aqeelarshad19/apartment_door_connected/Images/20200323_183214.jpg

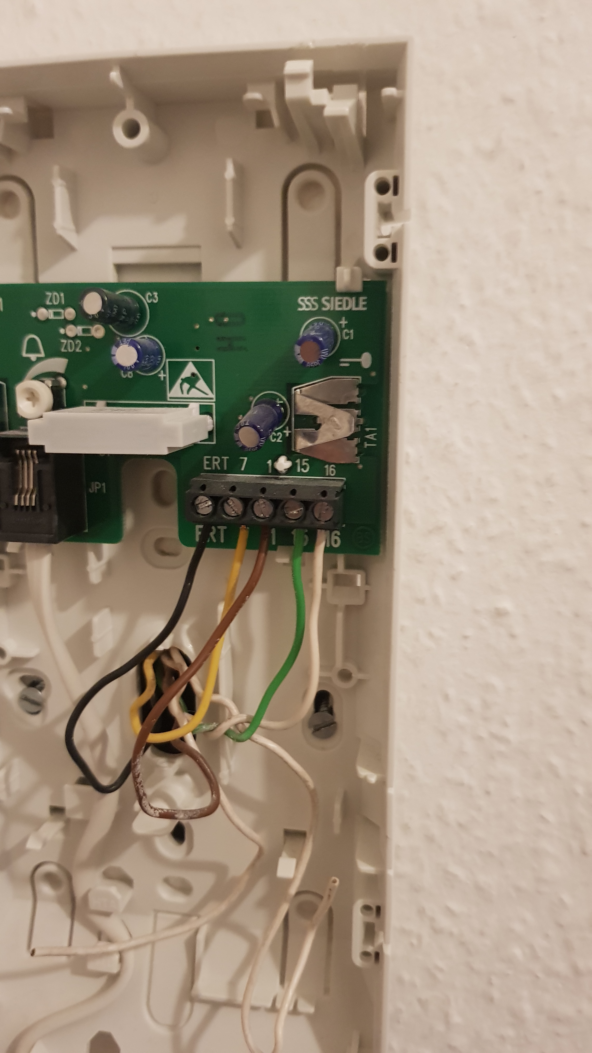
Images/20200323_183214.jpg
