aqeelarshad19/apartment_door_connected/Images/20200323_184217.jpg

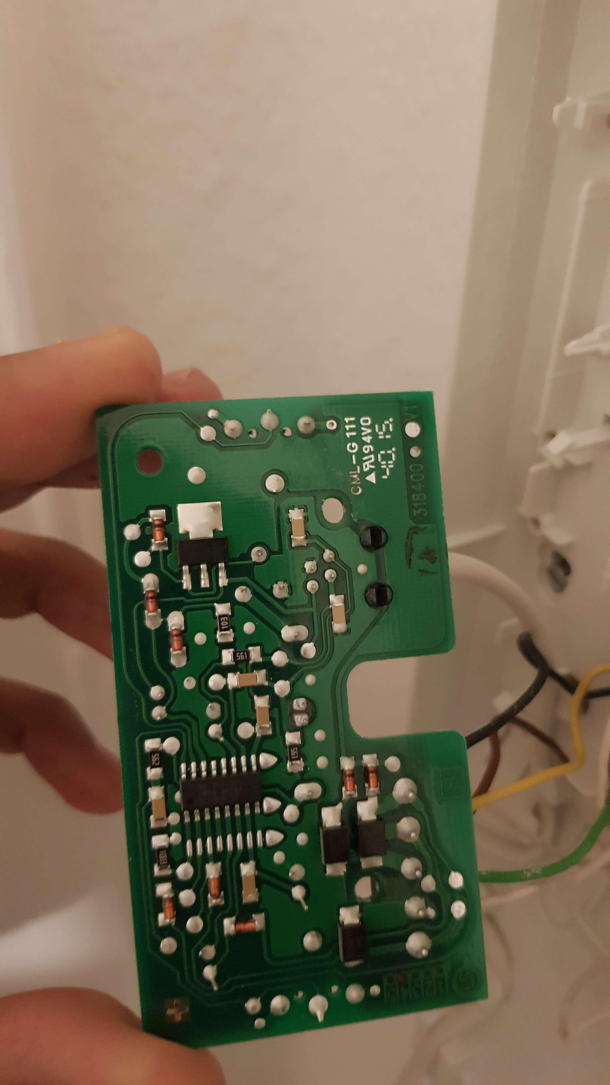
Images/20200323_184217.jpg
