aqeelarshad19/apartment_door_connected/Images/20200323_184233.jpg

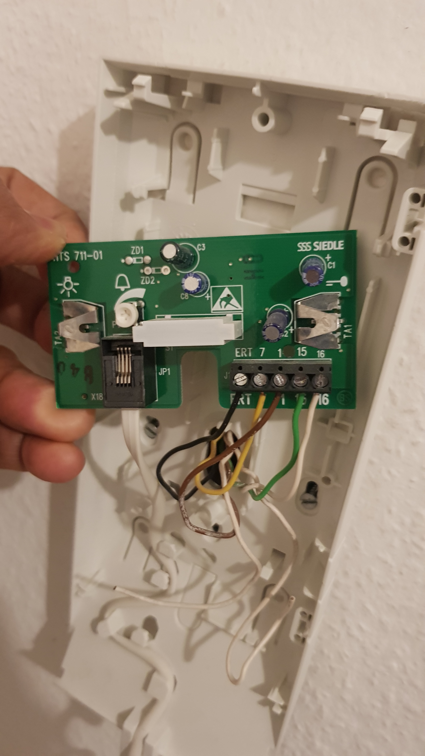
Images/20200323_184233.jpg
