aqeelarshad19/apartment_door_connected/Images/20200325_193451.jpg

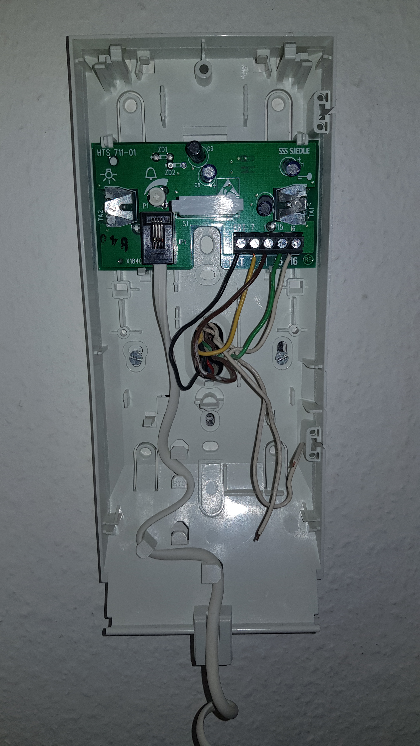
Images/20200325_193451.jpg
