aqeelarshad19/apartment_door_connected/Images/20200328_234504.jpg

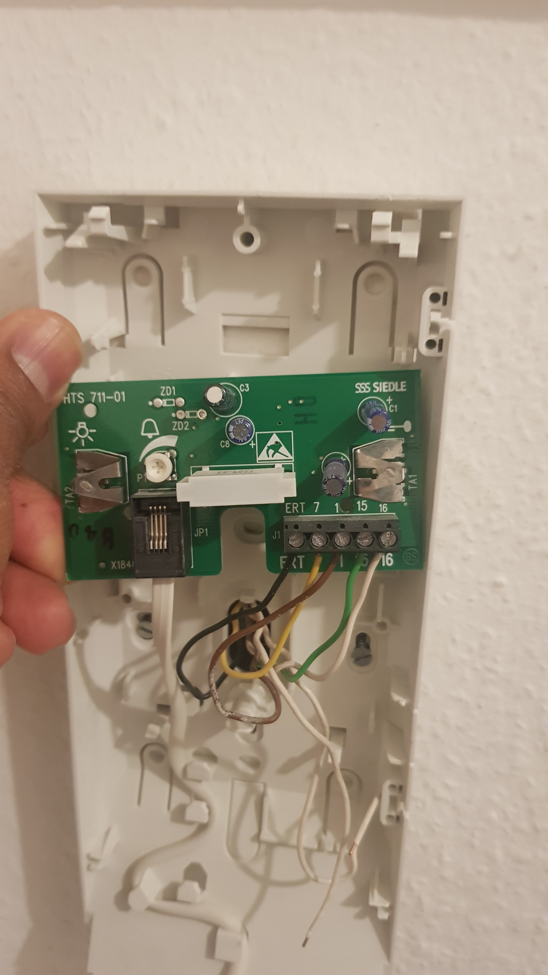
Images/20200328_234504.jpg
