aqeelarshad19/apartment_door_connected/Images/20200329_000736.jpg

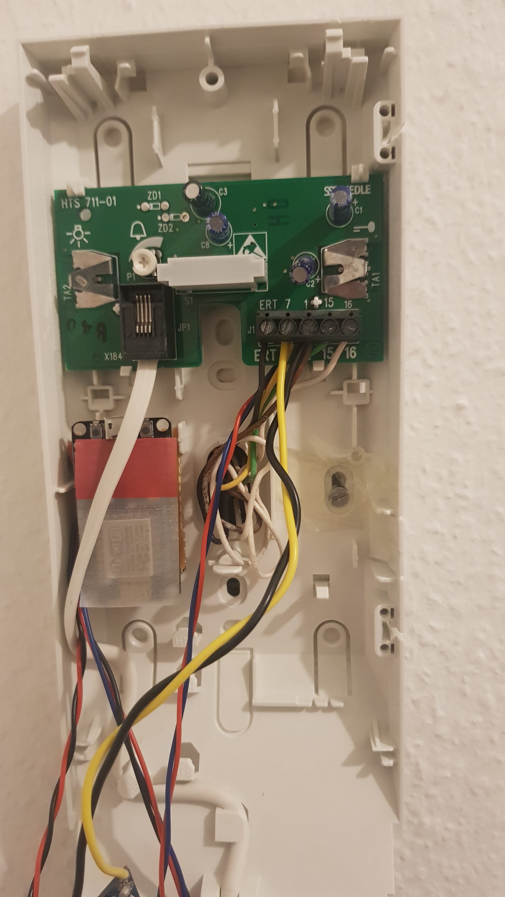
Images/20200329_000736.jpg
