aqeelarshad19/apartment_door_connected/Images/circuit_complete_2.jpg

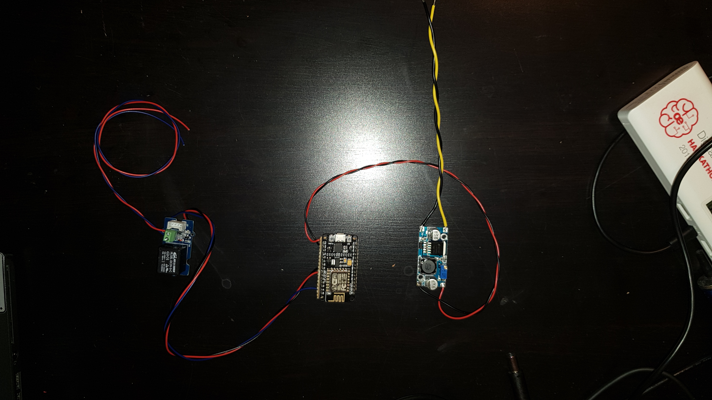
Images/circuit_complete_2.jpg
