aqeelarshad19/apartment_door_connected/Images/complete_hidden.jpg

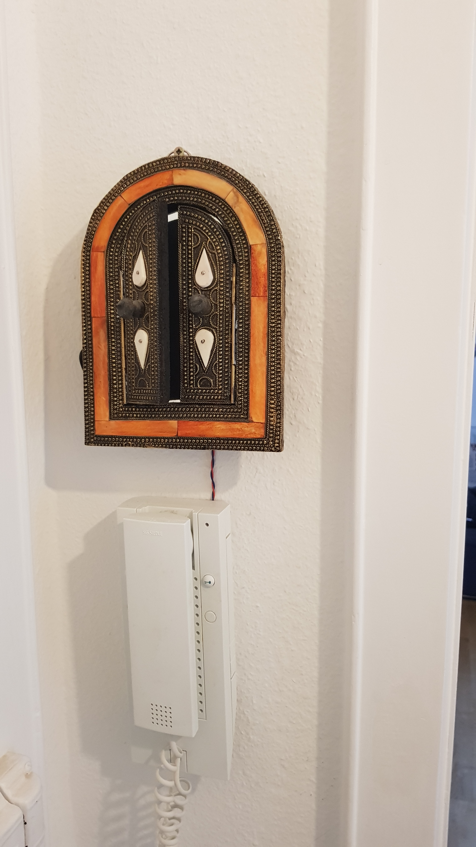
Images/complete_hidden.jpg
