aqeelarshad19/apartment_door_connected/Images/complete_hidden_2.jpg

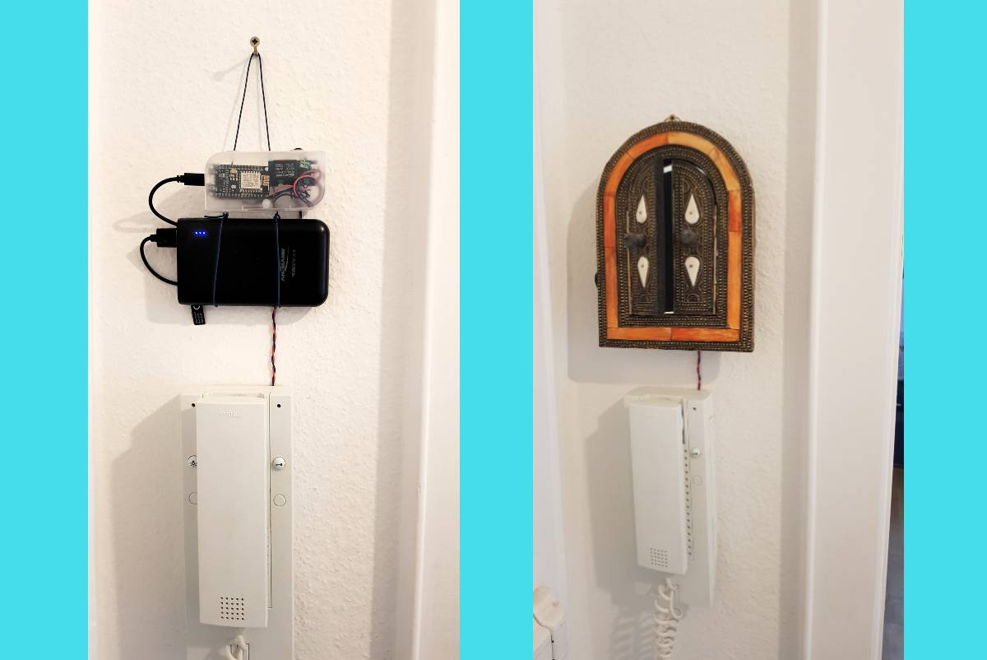
Images/complete_hidden_2.jpg
