aqeelarshad19/apartment_door_connected/Images/connected_with_usb_bank.jpg

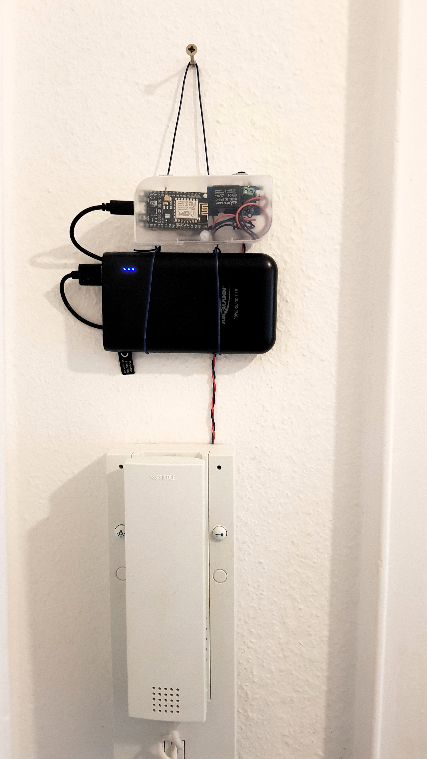
Images/connected_with_usb_bank.jpg
