aqeelarshad19/apartment_door_connected/Images/Keys_On_White_Background.jpg

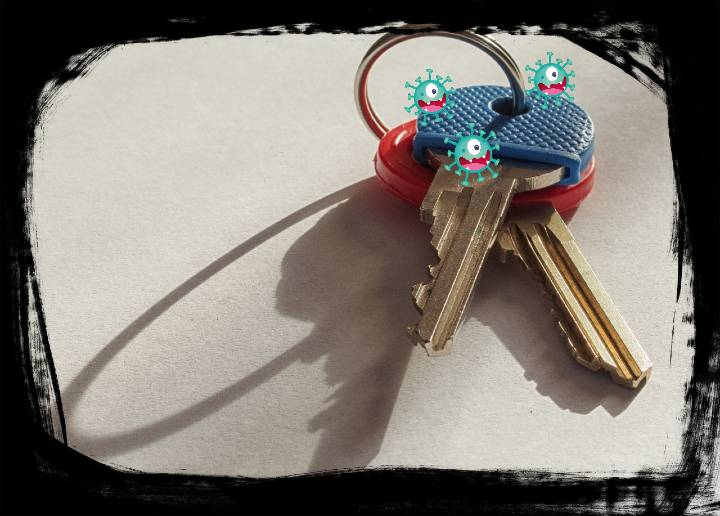
Images/Keys_On_White_Background.jpg
