aqeelarshad19/apartment_door_connected/Images/Screenshot_20200323-184046_SwissArmyKnife.jpg

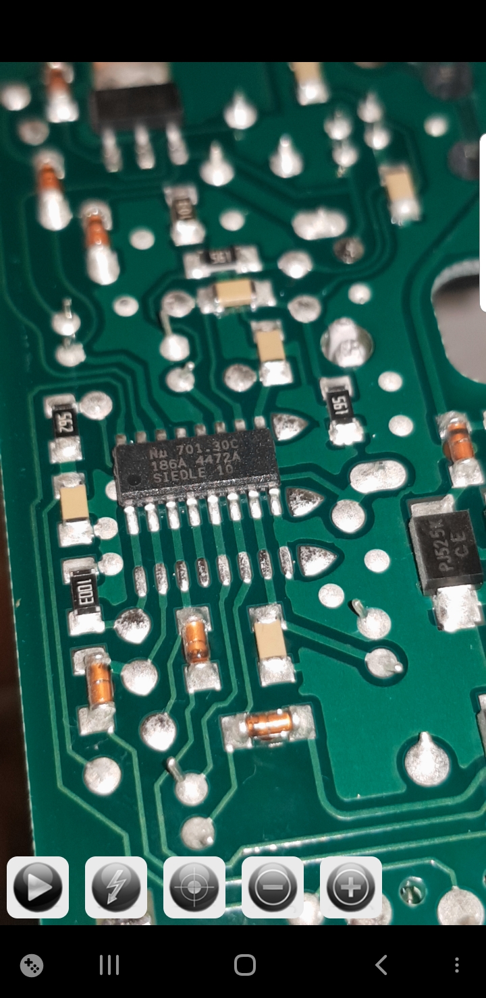
Images/Screenshot_20200323-184046_SwissArmyKnife.jpg
