aqeelarshad19/apartment_door_connected/Images/Screenshot_20200329-001040_Gallery.jpg

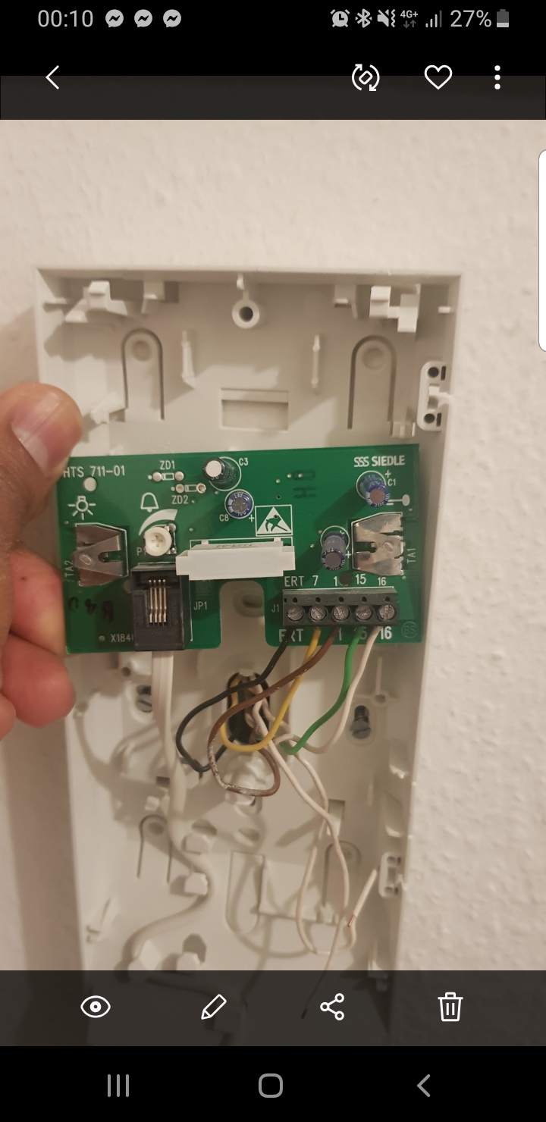
Images/Screenshot_20200329-001040_Gallery.jpg
