aqeelarshad19/apartment_door_connected/Images/siedle-spannungen-anmerkung-2019-11-18-100717.png

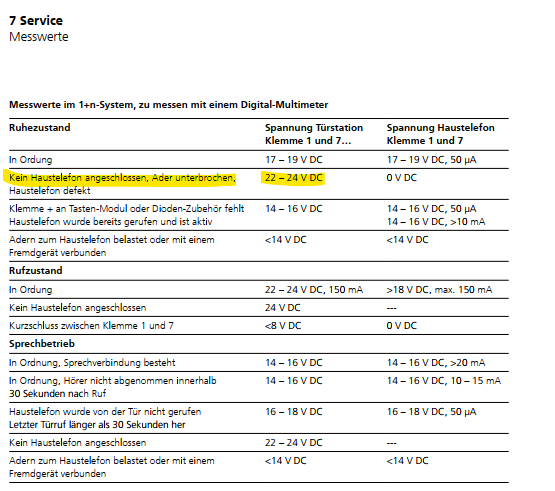
Images/siedle-spannungen-anmerkung-2019-11-18-100717.png
