aqeelarshad19/apartment_door_connected/Images/building-48626_1280.png

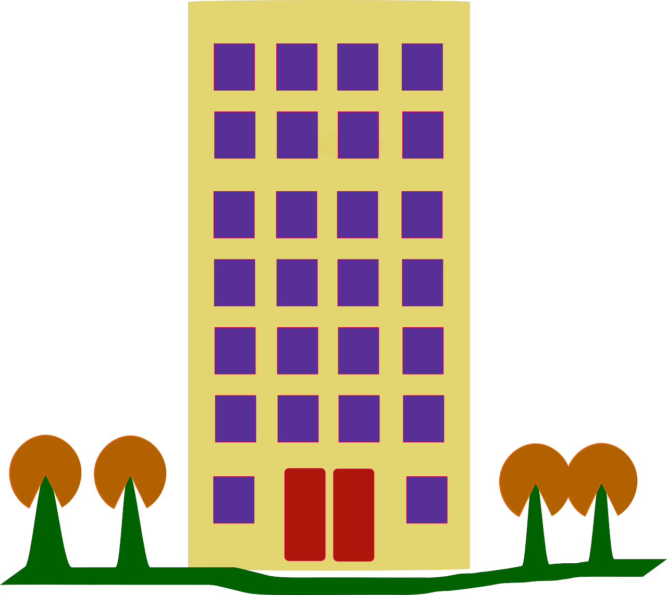
Images/building-48626_1280.png
