aqeelarshad19/apartment_door_connected/Images/139_20170916_135206.jpg

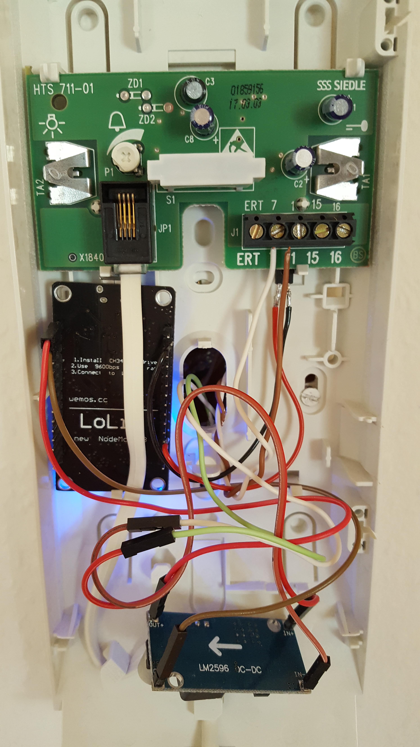
Images/139_20170916_135206.jpg
